johnyHV/ChristmasTreeLights/documentation/H66479ceb6e3e4e74b99c3ff3e72c2725p.jpg

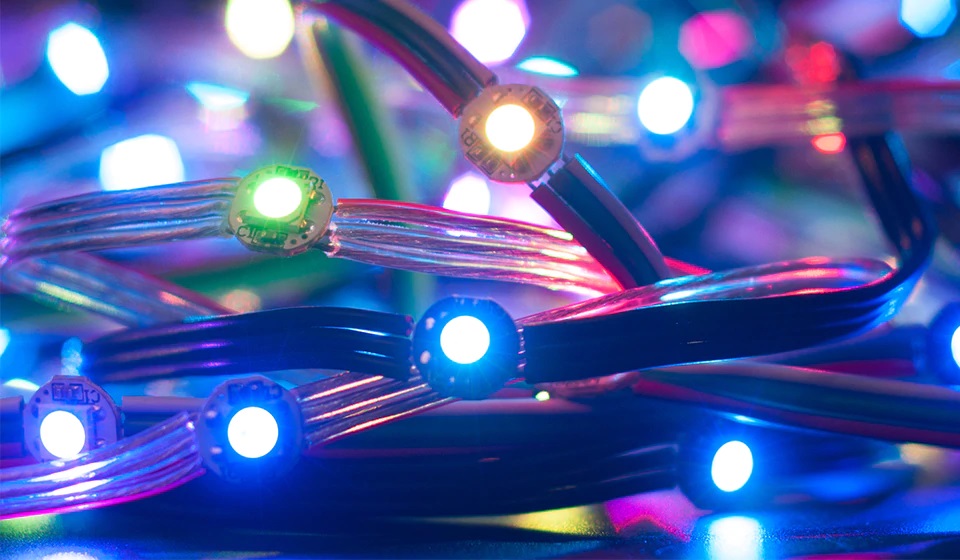
documentation/H66479ceb6e3e4e74b99c3ff3e72c2725p.jpg
