johnyHV/ChristmasTreeLights/documentation/NeoPixel-Images.png

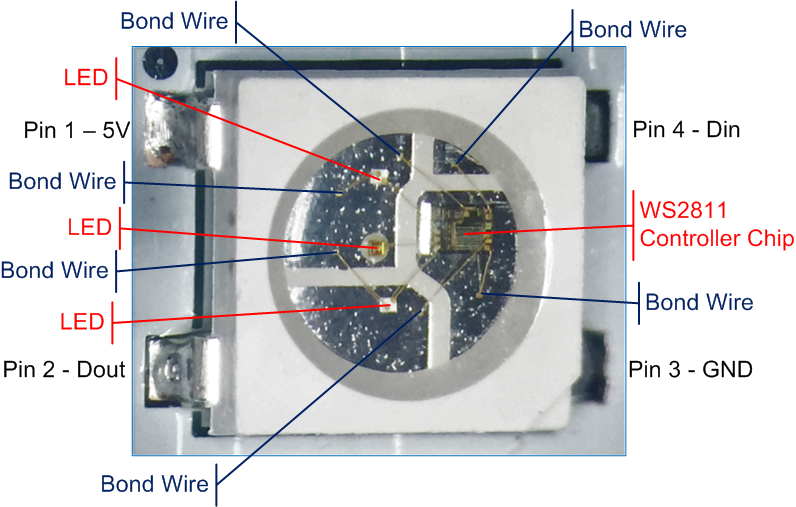
documentation/NeoPixel-Images.png
