johnyHV/ChristmasTreeLights/README.md

Christmas Tree Lights with WI-FI modul ESP-01

3D model for case
https://www.thingiverse.com/thing:5159394

Image description

Youtube video
IMAGE ALT TEXT HERE (https://youtu.be/0uyXQOq69ik)
