johnyHV/ChristmasTreeLights/documentation/31ceoA4c9aL._AC_.jpg

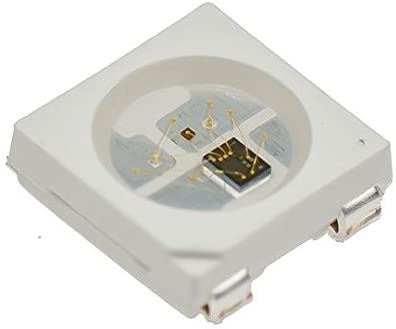
documentation/31ceoA4c9aL._AC_.jpg
