johnyHV/ChristmasTreeLights/documentation/H9e1b18ddbb3344a68596960ab7cfa6be7.webp

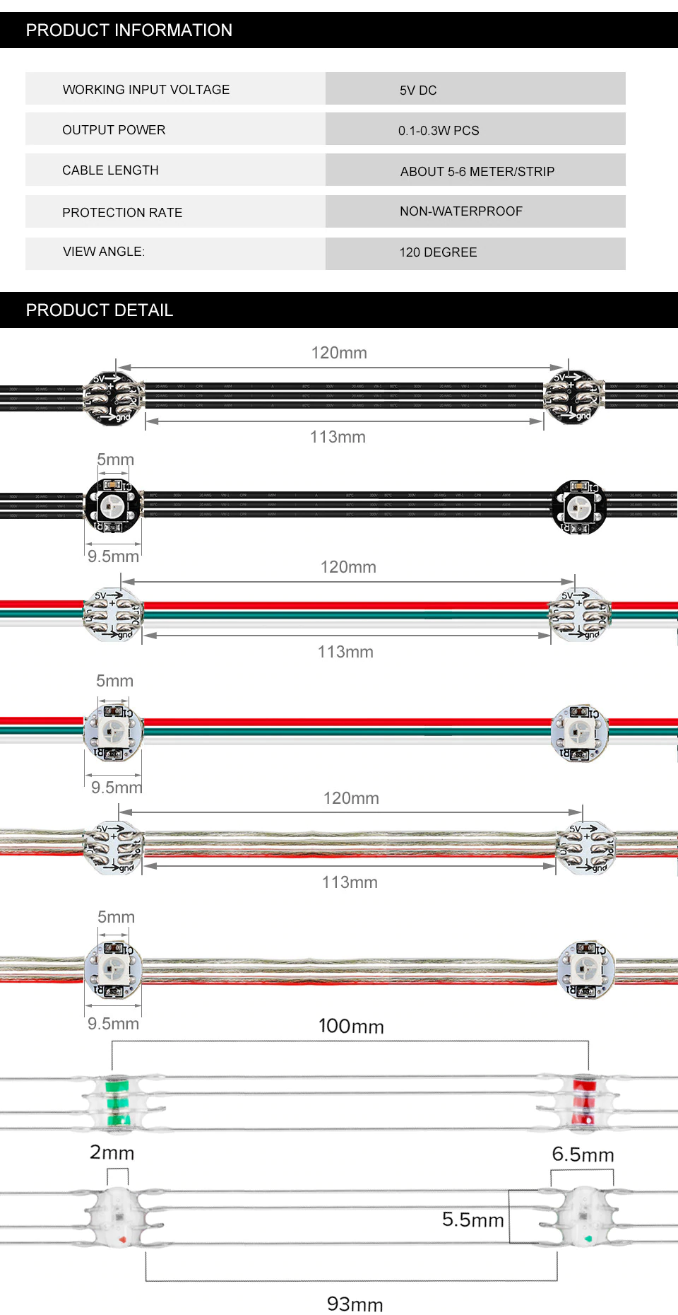
documentation/H9e1b18ddbb3344a68596960ab7cfa6be7.webp
