johnyHV/ChristmasTreeLights/documentation/I-15068.jpg

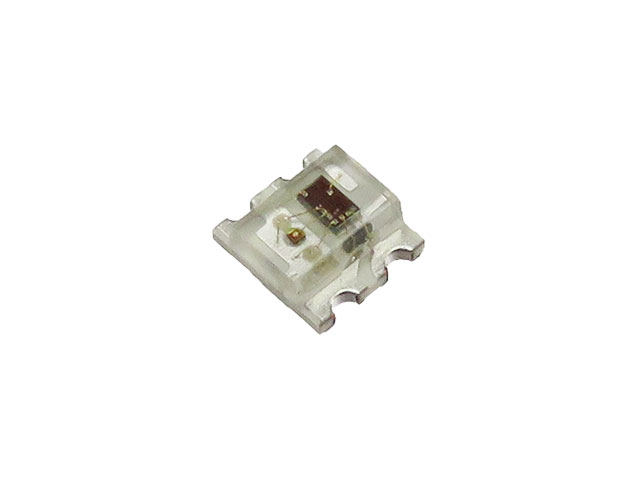
documentation/I-15068.jpg
