johnyHV/ChristmasTreeLights/documentation/unnamed.jpg

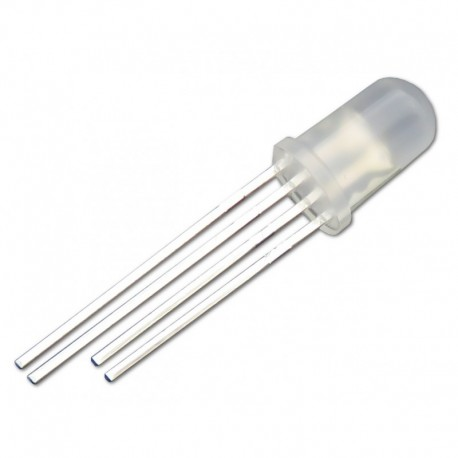
documentation/unnamed.jpg
