johnyHV/ChristmasTreeLights/documentation/WEB.png

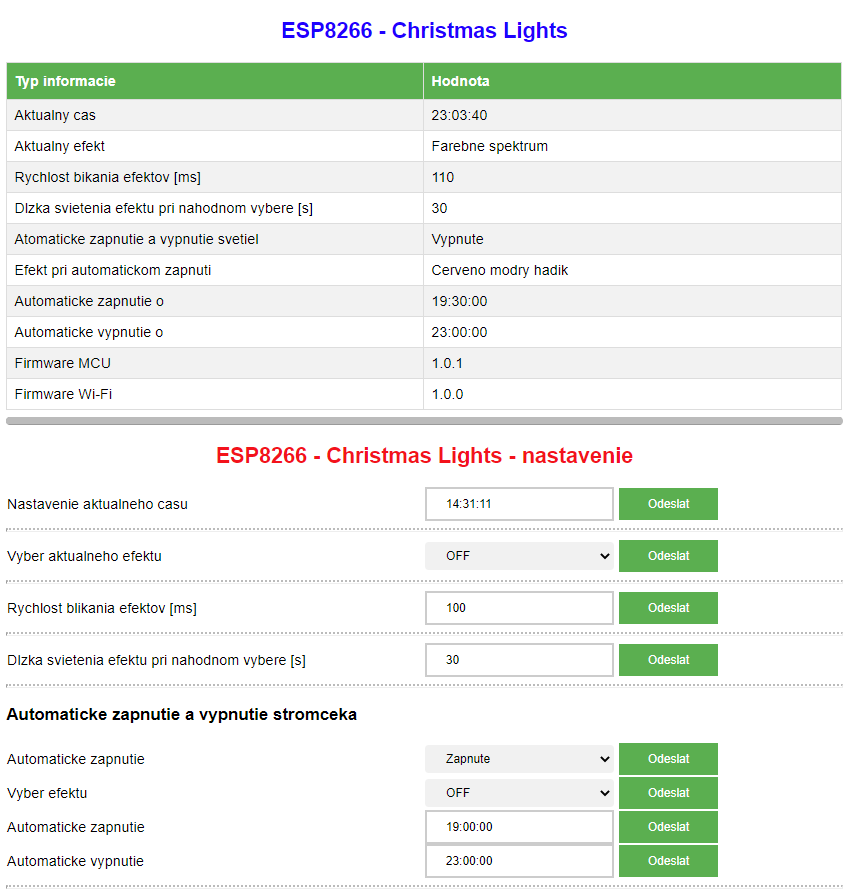
documentation/WEB.png
