johnyHV/ChristmasTreeLights/documentation/ws2812-series-led-upgrade-instructions-3-638.jpg

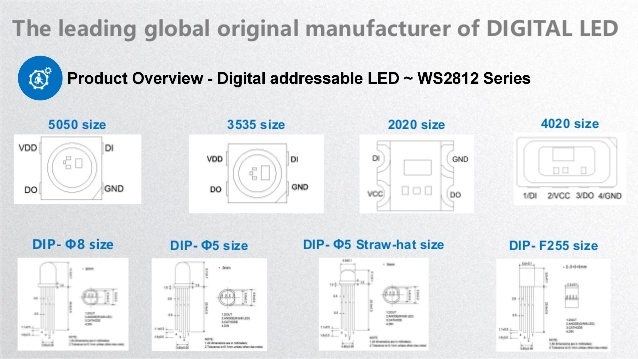
documentation/ws2812-series-led-upgrade-instructions-3-638.jpg
