johnyHV/ChristmasTreeLights/documentation/ws2812-series-led-upgrade-instructions-4-638.jpg

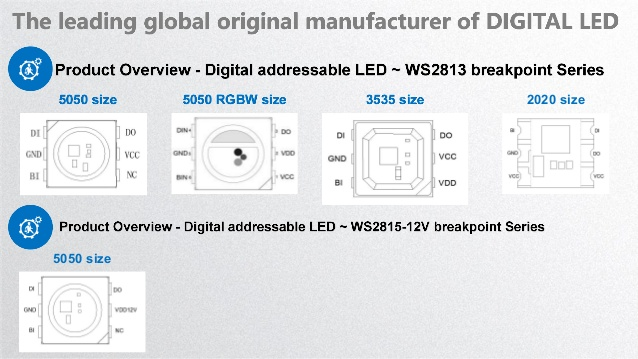
documentation/ws2812-series-led-upgrade-instructions-4-638.jpg
