johnyHV/ChristmasTreeLights/PCB/Stromcek v1.0.brd

## EAGLE design PCB/Stromcek v1.0.brd (2020-11-29)

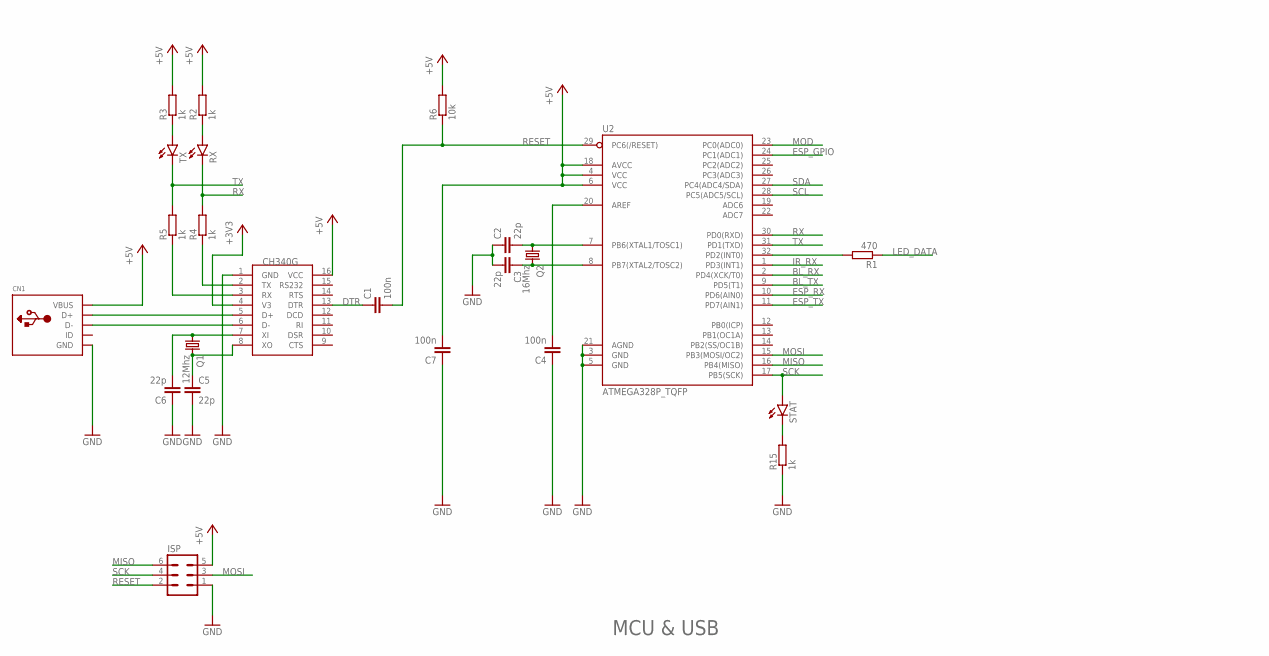
[picture p26: schematic Stromcek v1.0.sch, part in row 1, column 1]

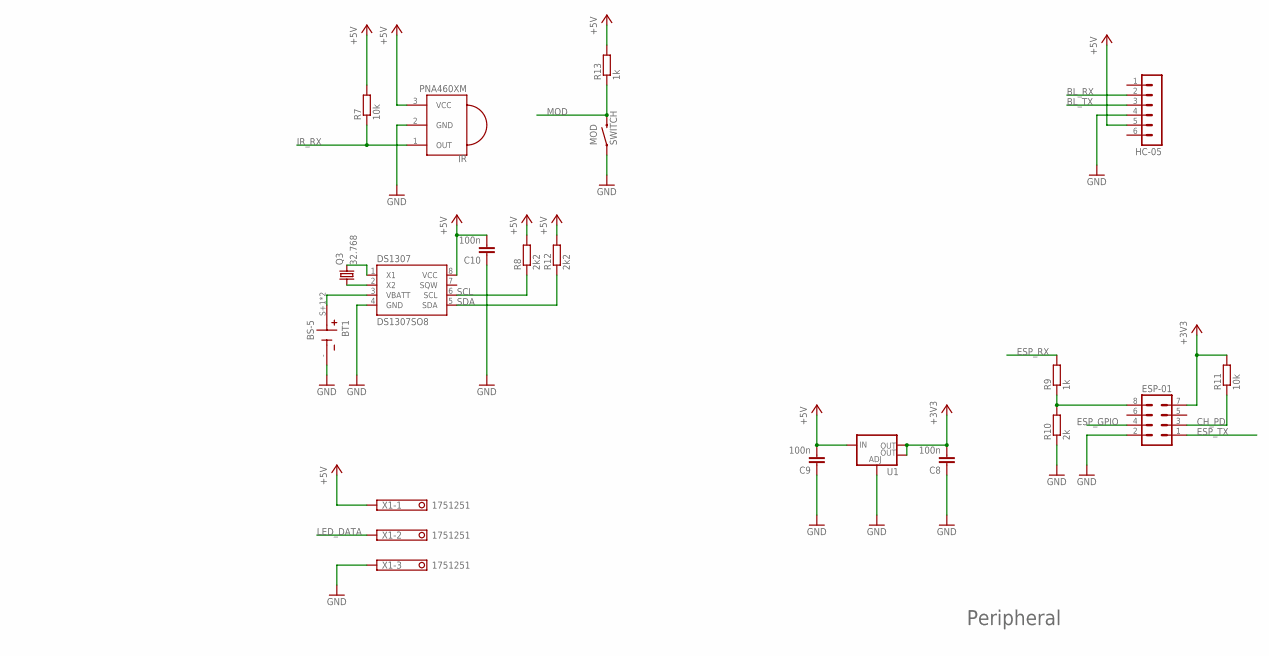
[picture p27: schematic Stromcek v1.0.sch, part in row 1, column 2]

Parts:
BT1: BS-5; BAT_BS-5
C1, C4, C7, C8, C9, C10: 100n; C0603
C2, C3, C5, C6: 22p; C0603
CN1: USBMOLEX; USB-MINIB-THM-MOLEX
DS1307: DS1307SO8; SO08
ESP-01: MA04-2
HC-05: MA06-1
IR: PNA460XM
ISP: MA03-2
MOD: SWITCH; TACTILE-PTH-EZ
Q1: 12Mhz; HC49UP
Q2: 16Mhz; HC49UP
Q3: 32.768; TC26
R1: 470; R0603
R2, R3, R4, R5, R9, R13, R15: 1k; R0603
R6, R7, R11: 10k; R0603
R8, R12: 2k2; R0603
R10: 2k; R0603
RX: LEDSML0805; SML0805
STAT: LEDSML0805; SML0805
TX: LEDSML0805; SML0805
U1: V_REG_LM1117SOT223; SOT223
U2: ATMEGA328P_TQFP; TQFP32-08
U$1: CH340G; SOIC16
X1: 1751251

Connections:
+3V3: C8.2, ESP-01.7, R11.2, U1.2 (OUT), U1.4 (OUT), U$1.4 (V3)
+5V: C7.2, C9.2, C10.2, CN1.VBUS, DS1307.8 (VCC), HC-05.5, IR.3 (VCC), ISP.5, R2.2, R3.2, R6.2, R7.2, R8.2, R12.2, R13.2, U1.3 (IN), U2.4 (VCC), U2.6 (VCC), U2.18 (AVCC), U$1.16 (VCC), X1.1
BL_RX: HC-05.2, U2.2 (PD4(XCK/T0))
BL_TX: HC-05.3, U2.9 (PD5(T1))
CH_PD: ESP-01.3, R11.1
DTR: C1.1, U$1.13 (DTR)
ESP_GPIO: ESP-01.4, U2.24 (PC1(ADC1))
ESP_RX: R9.2, U2.10 (PD6(AIN0))
ESP_RX_: ESP-01.8, R9.1, R10.2
ESP_TX: ESP-01.1, U2.11 (PD7(AIN1))
GND: BT1.-, C2.1, C3.2, C4.1, C5.2, C6.1, C7.1, C8.1, C9.1, C10.1, CN1.GND, CN1.GND1 (GND), CN1.GND4 (GND), DS1307.4 (GND), ESP-01.2, HC-05.4, IR.2 (GND), ISP.1, MOD.1, R10.1, R15.1, U1.1 (ADJ), U2.3 (GND), U2.5 (GND), U2.21 (AGND), U$1.1 (GND), X1.3
IR_RX: IR.1 (OUT), R7.1, U2.1 (PD3(INT1))
LED_DATA: R1.1, X1.2
MISO: ISP.6, U2.16 (PB4(MISO))
MOD: MOD.3 (2), R13.1, U2.23 (PC0(ADC0))
MOSI: ISP.3, U2.15 (PB3(MOSI/OC2))
unnamed: CN1.D+, U$1.5 (D+)
unnamed: R1.2, U2.32 (PD2(INT0))
unnamed: CN1.D-, U$1.6 (D-)
unnamed: R5.1, U$1.3 (RX)
unnamed: R4.1, U$1.2 (TX)
unnamed: C2.2, Q2.1, U2.7 (PB6(XTAL1/TOSC1))
unnamed: C6.2, Q1.1, U$1.7 (XI)
unnamed: C5.1, Q1.2, U$1.8 (XO)
unnamed: R2.1, RX.A
unnamed: R3.1, TX.A
unnamed: C3.1, Q2.2, U2.8 (PB7(XTAL2/TOSC2))
unnamed: C4.2, U2.20 (AREF)
unnamed: R15.2, STAT.C
unnamed: BT1.S+1 (+), BT1.S+2 (+), DS1307.3 (VBATT)
unnamed: DS1307.2 (X2), Q3.1
unnamed: DS1307.1 (X1), Q3.2
RESET: C1.2, ISP.2, R6.1, U2.29 (PC6(/RESET))
RX: R4.2, RX.C, U2.30 (PD0(RXD))
SCK: ISP.4, STAT.A, U2.17 (PB5(SCK))
SCL: DS1307.6 (SCL), R8.1, U2.28 (PC5(ADC5/SCL))
SDA: DS1307.5 (SDA), R12.1, U2.27 (PC4(ADC4/SDA))
TX: R5.2, TX.C, U2.31 (PD1(TXD))

Notes on the sheet:
MCU & USB
Peripheral

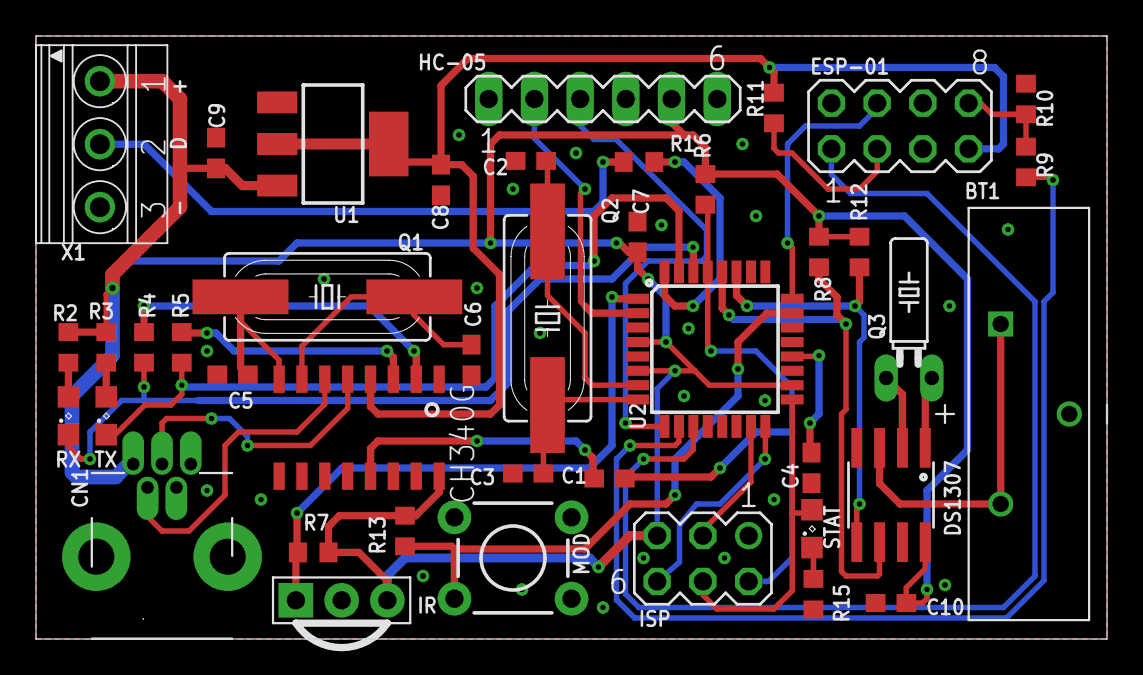
[picture p28: board Stromcek v1.0.brd from above]

Board: 2 copper layers, 59.5 x 33.5 mm, 42 parts (0 on the bottom side), 38 nets.
