johnyHV/ChristmasTreeLights/SW/MainBoard/LedEffect_command.h

/**
   @file LedEffect_command.h

   @brief identifikatory jednotlivych LED efektov

   @author Miroslav Pivovarsky
   Contact: miroslav.pivovarsky@gmail.com

   @bug: no know bug

*/

#ifndef _LED_EFFECT_COMMAND_H_
#define _LED_EFFECT_COMMAND_H_

#define LED_EFFECT_OFF              '0'
#define LED_EFFECT_RED              '1'
#define LED_EFFECT_GREEN            '2'
#define LED_EFFECT_BLUE             '3'
#define LED_EFFECT_WHITE            '4'
#define LED_EFFECT_YELLOW           '5'
#define LED_EFFECT_COLLOR_SPECTRUM  '6'
#define LED_EFFECT_COLOR_SNAKE      '7'
#define LED_EFFECT_COLOR_SNAKE_FULL '8'
#define LED_EFFECT_RED_BLUE_SNAKE   '9'
#define LED_EFFECT_5                'A'
#define LED_EFFECT_WHITE_SNAKE      'B'
#define LED_EFFECT_7                'C'
#define LED_EFFECT_8                'D'
#define LED_EFFECT_9                'E'
#define LED_EFFECT_10               'F'
#define LED_EFFECT_11               'G'
#define LED_EFFECT_LAVA             'H'
#define LED_EFFECT_OCEAN            'I'
#define LED_EFFECT_FOREST           'J'
#define LED_EFFECT_RANDOM           'K'

#endif
